mworion/Mechanics/README.md

# Mechanics
Mechanical Ideas for Astro Imaging
