mworion/Mechanics/source/mechanics/cables_qhy/index.rst

Securing power and USB connector
================================

.. warning:: Before starting please check if this solution also work for your
             environment. This means please check carefully dimensions and
             devices. This setup might not work for you.

.. warning:: Changes on all devices are made at your own risk!

Description of parts for QSI690 connectors
------------------------------------------

Image of the thread on the QSI690 filter wheel

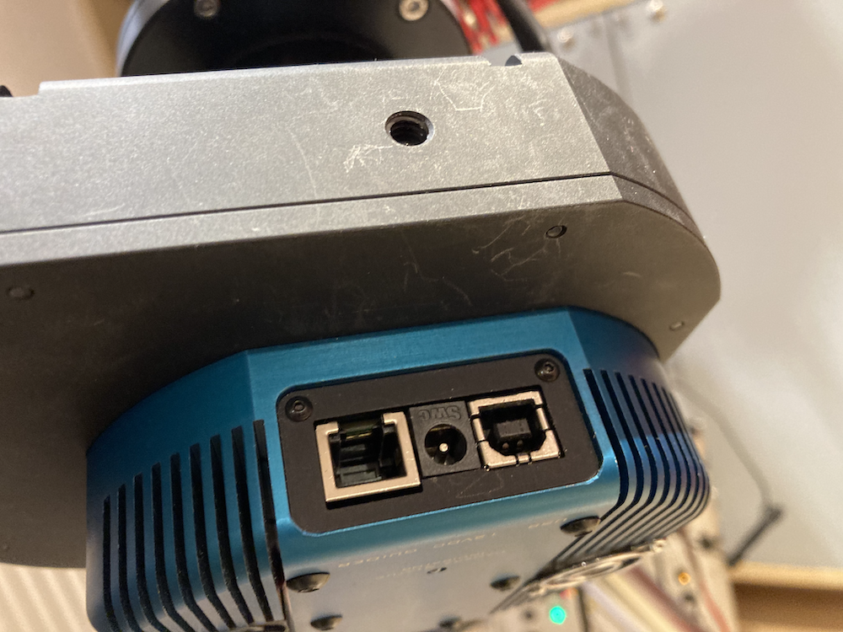
[picture p14: source/mechanics/image/img_9551.png]
