mworion/Mechanics/source/mechanics/cables_rig/index.rst

Cable Management On Rig
=======================
As I do not like cable ties to be spread overall, I started to get a clean cable
management on the rig itself. For this reason I started to print cable channels,
which are attached to the dovetails. The advantage is if you need to remove a wire
you just could do it without any tools.

So I started removing all the cable ties from my rig. PartI.

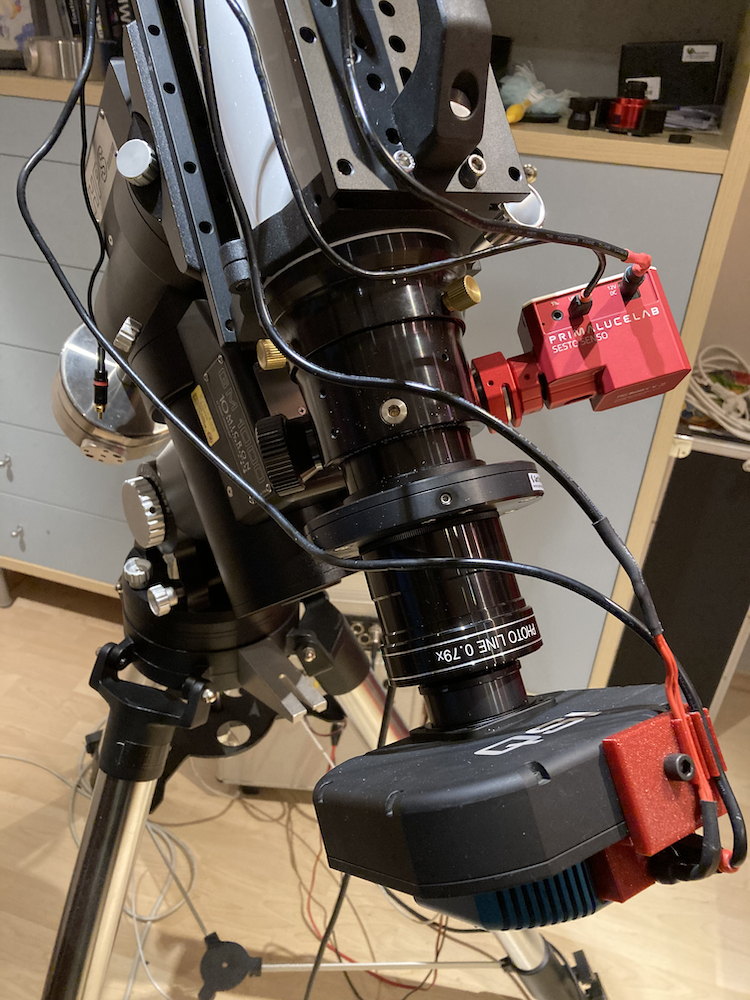
[picture p15: source/mechanics/cables_rig/image/img_9575.png]


Part II.

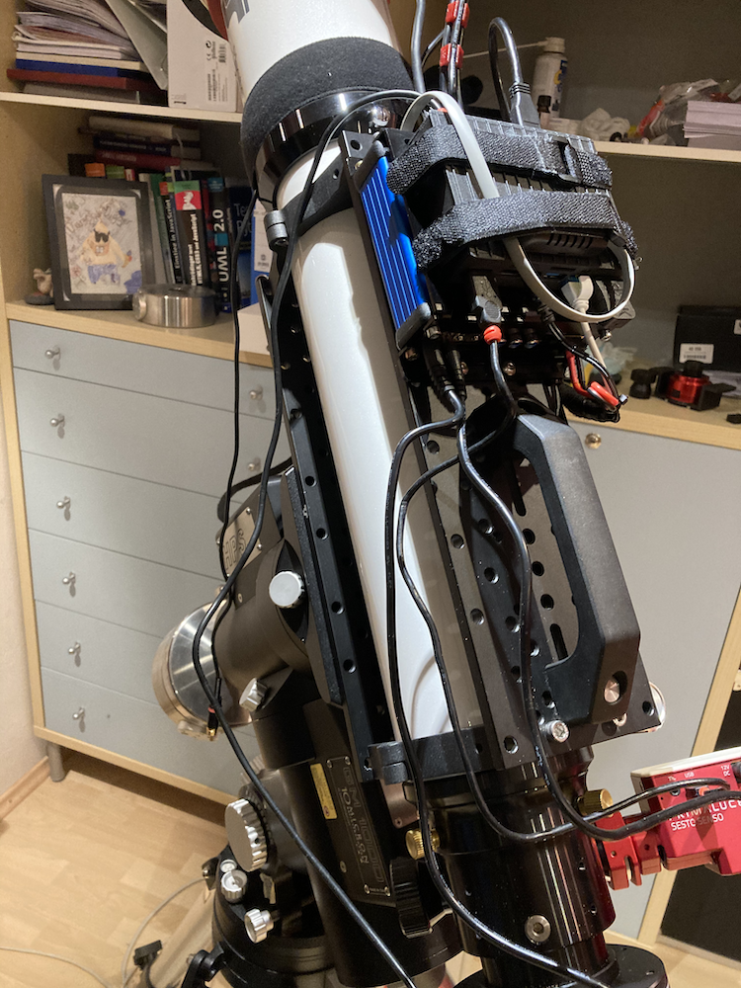
[picture p16: source/mechanics/cables_rig/image/img_9576.png]


And the printed channels attached to the dovetail.

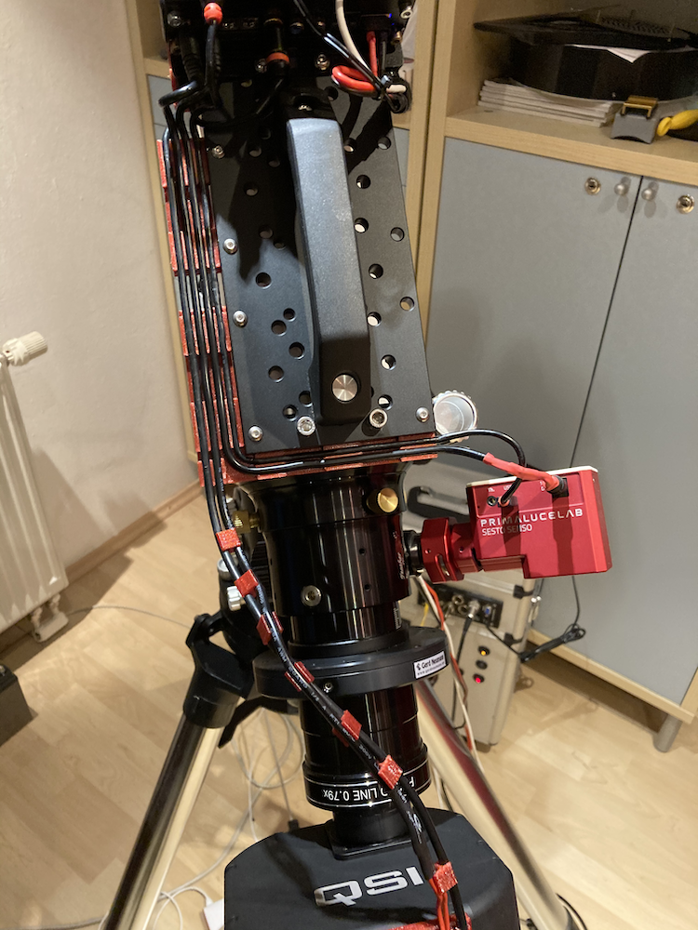
[picture p17: source/mechanics/cables_rig/image/img_9577.png]


I also did some clips to attach two cable to each other.

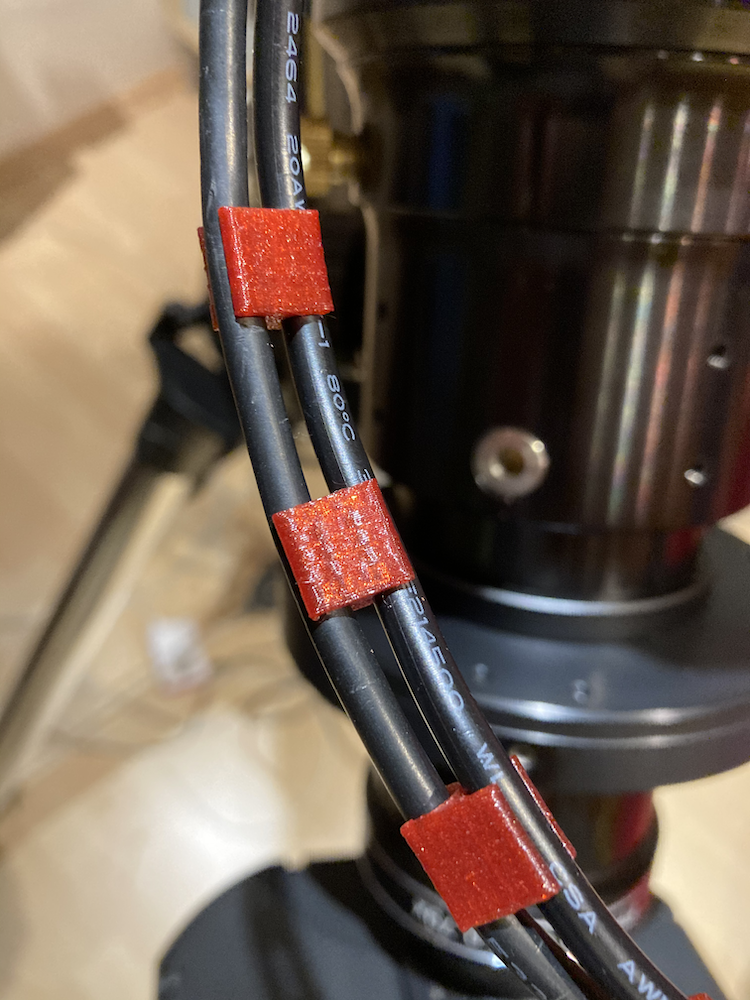
[picture p18: source/mechanics/cables_rig/image/img_9578.png]


Detailed view on the left side where the connections for focuser and ccd (USB and
power) are alinged to each other.

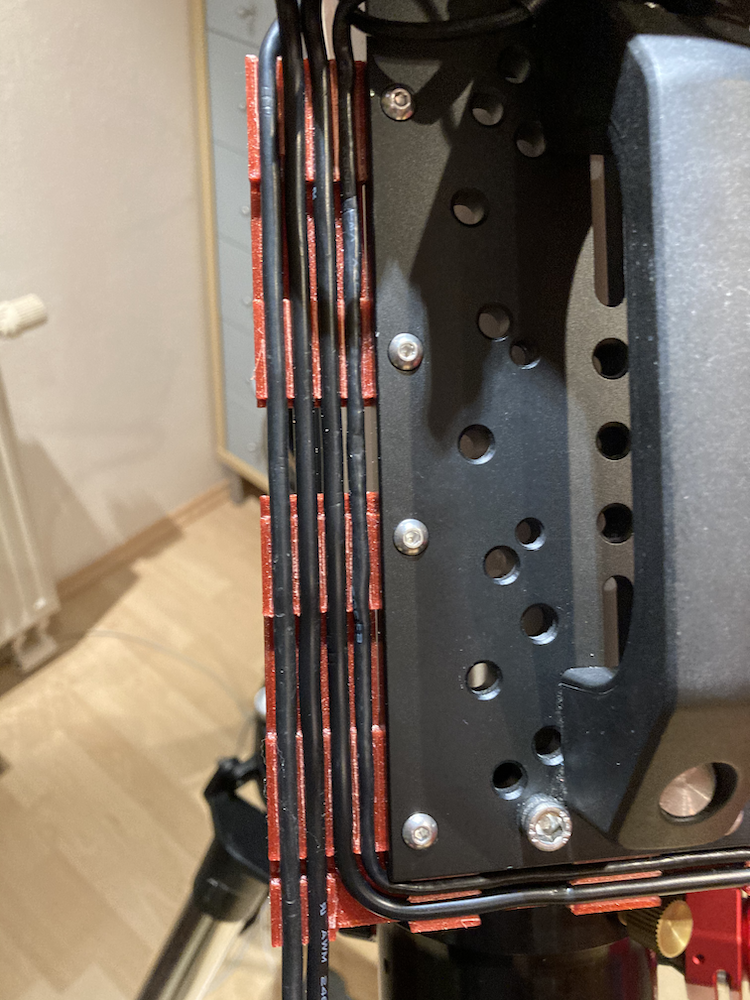
[picture p19: source/mechanics/cables_rig/image/img_9579.png]


The two lines which direct to the focuser on the right side.

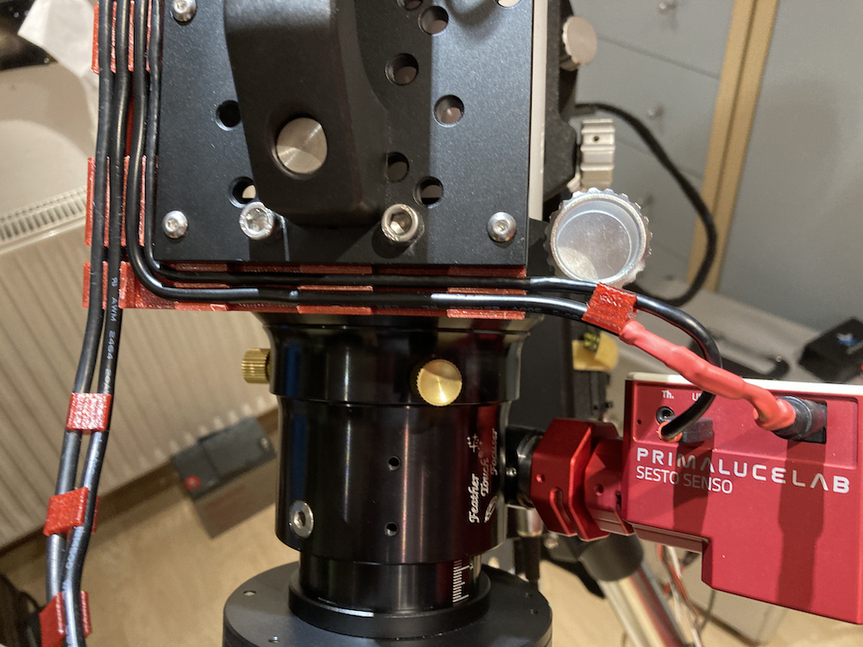
[picture p20: source/mechanics/cables_rig/image/img_9580.png]


Passing the Pegasus UPB below with Power for Dew and the USB for the camera (which
is attache to the front of the Mini PC (USB3). Part I

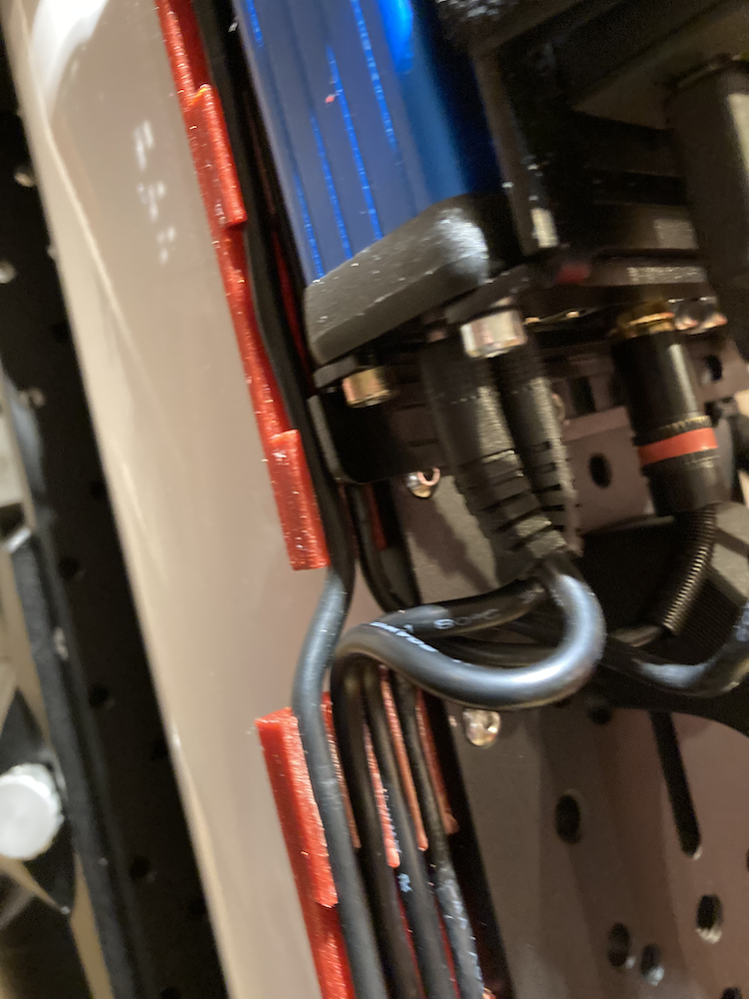
[picture p21: source/mechanics/cables_rig/image/img_9581.png]


Part II

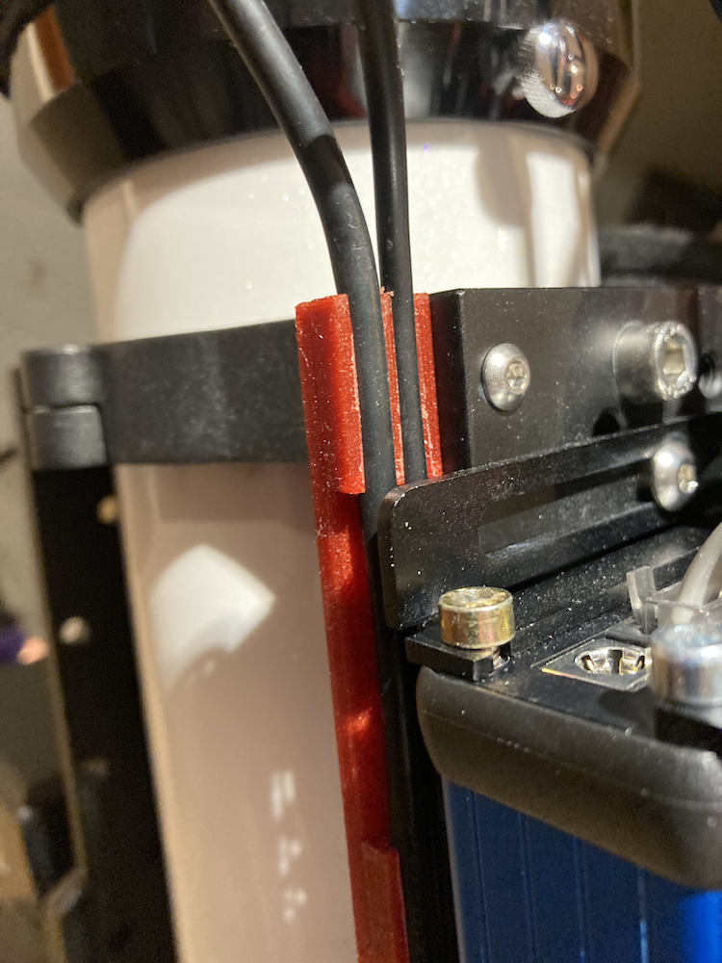
[picture p22: source/mechanics/cables_rig/image/img_9582.png]
