mworion/Mechanics/source/mechanics/cables_qsi/index.rst

Securing power and USB connector
================================

.. warning:: Before starting please check if this solution also work for your
             environment. This means please check carefully dimensions and
             devices. This setup might not work for you.

.. warning:: Changes on all devices are made at your own risk!

Description of parts for QSI690 connectors
------------------------------------------

.. note:: Please use adequate parts if you would like to follow the example. In
          my setup the wires are used for connecting to PegasusUPBv2.

Two part for the holder and one screw fitting to the thread in the attached
filter wheel of the QSI camera

The wo holder parts

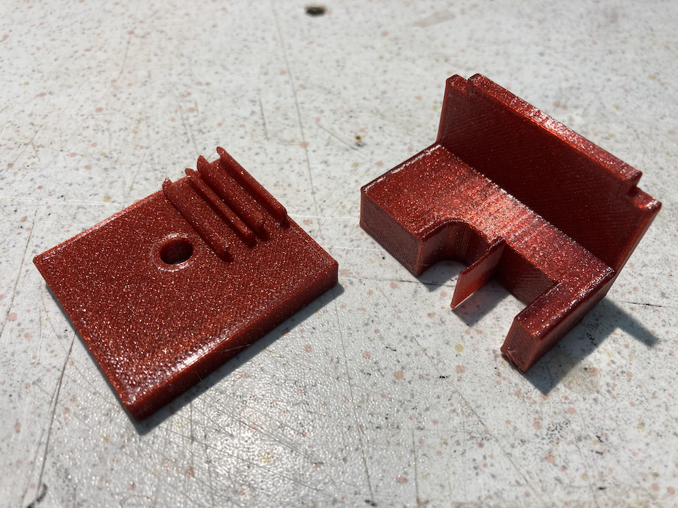
[picture p23: source/mechanics/cables_qsi/image/img_9549.png]


The fit together without any tool needed.

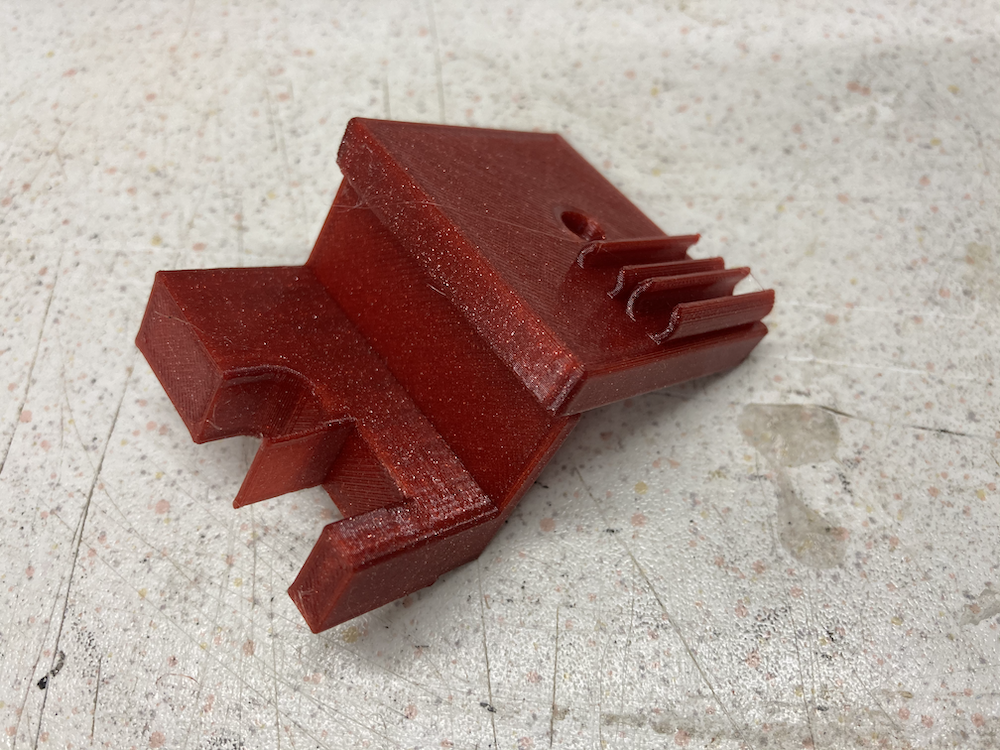
[picture p24: source/mechanics/cables_qsi/image/img_9550.png]


Image of the thread on the QSI690 filter wheel



1. Step: attaching the combined holder to the filter wheel
----------------------------------------------------------
Put the holder in top of the filter wheel and fit the screw

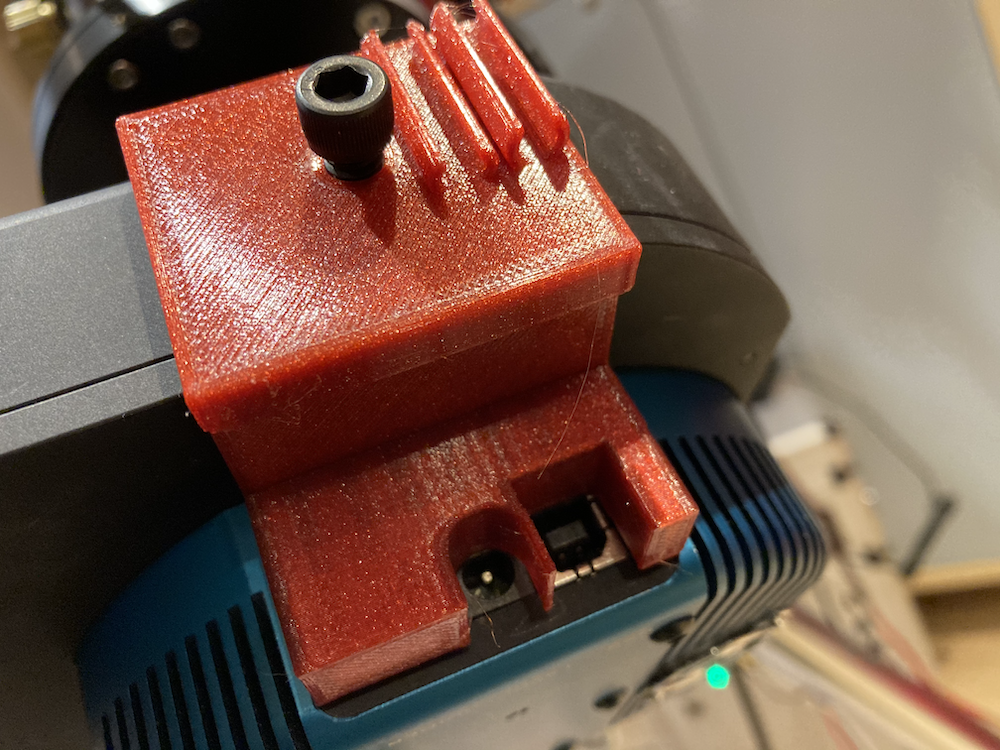
[picture p25: source/mechanics/cables_qsi/image/img_9552.png]


2. Step: tighten the screw and attaching the USB and power connector
--------------------------------------------------------------------

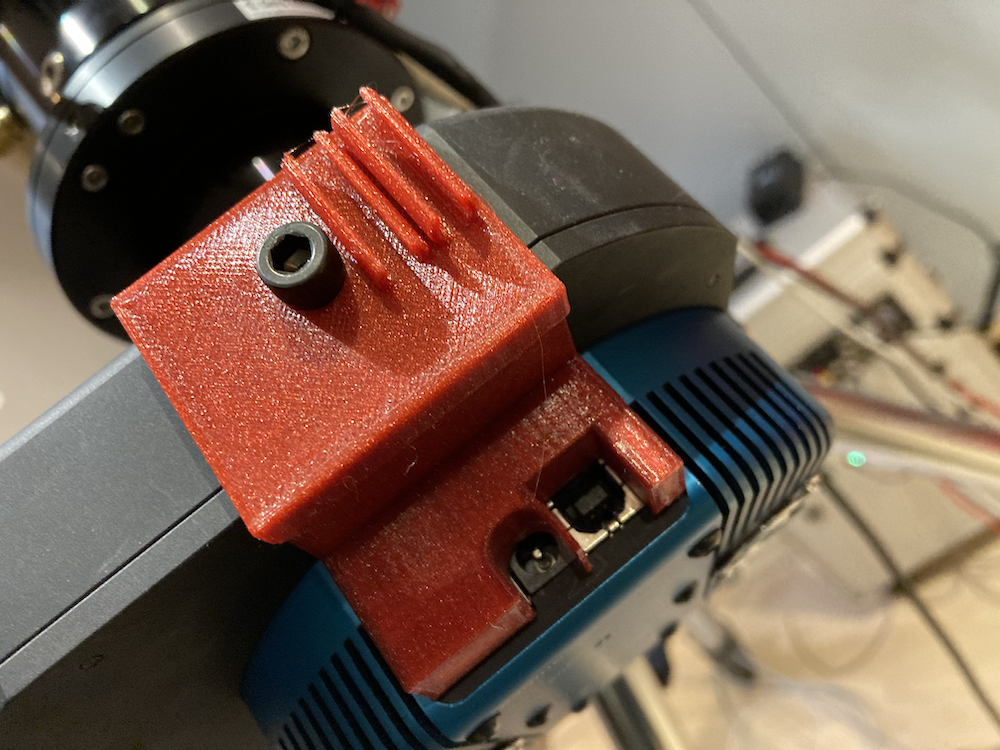
[picture p26: source/mechanics/cables_qsi/image/img_9553.png]


USB and power connector should fit in the designed places tight, but without
great force and keep them in the connector.

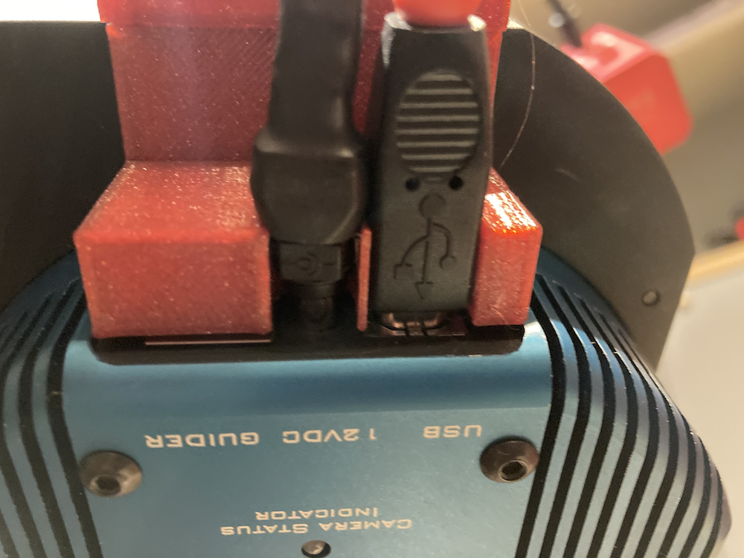
[picture p27: source/mechanics/cables_qsi/image/img_9554.png]


3. Step: link the wires to the brackets in top of the holder
------------------------------------------------------------

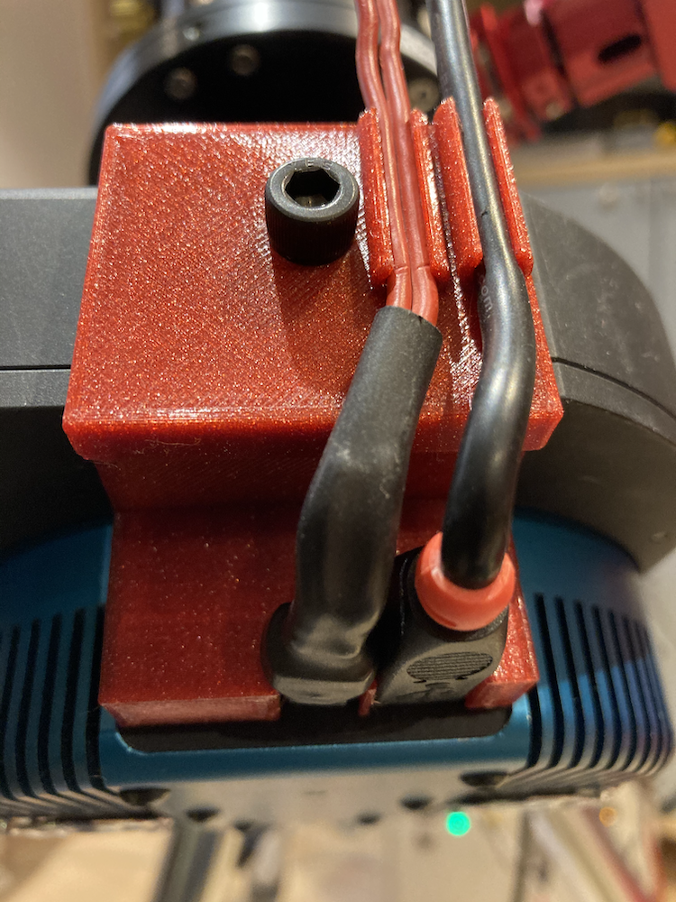
[picture p28: source/mechanics/cables_qsi/image/img_9555.png]
