mworion/Mechanics/source/mechanics/flipflat/index.rst

Mounting FlipFlat and SQR
=========================

.. warning:: Before starting please check if this solution also work for your
             environment. This means please check carefully dimensions and
             devices. This setup might not work for you.

.. warning:: Changes on all devices are made at your own risk!

Description of parts for FlipFlat / SQR holder
----------------------------------------------

.. note:: Please use adequate parts if you would like to follow the example. In
          my setup the diameter of the dew shield is 121.3 mm. It's a
          Teleskop-Express Photo Line TLAPO1027-FT.

2 x M4 x 30 mm for connection dew shield ring to holder attachment
2 x M4 x 15 mm for connecting the two dew shield rings
2 x UNC #6 x 1/2 for connecting the Alnitak FlipFlat to the holder
4 x M3 x 25mm self cutting screws for attaching the unihedron to the holder
1 base ring
1 attachment ring
1 holder

Parts: Unihedron and FlipFlat
-----------------------------
Back of the unihedron sqr with the USB interface.

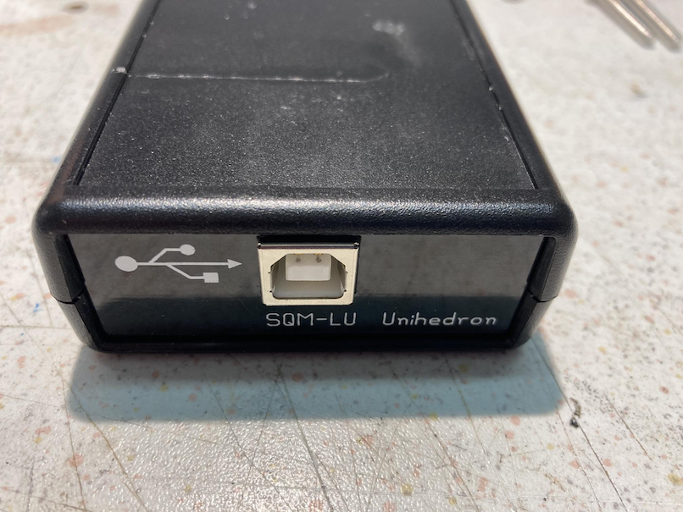
[picture p29: source/mechanics/flipflat/image/img_9482.png]


Front of the unihedron sqr with lens.

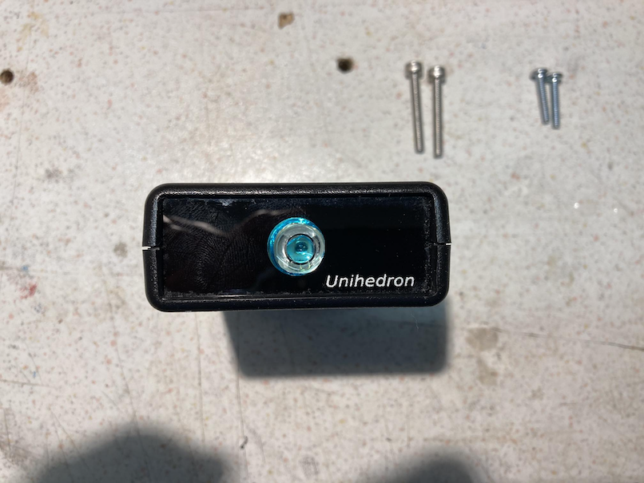
[picture p30: source/mechanics/flipflat/image/img_9483.png]


Alnitak Flip Flat device without any original holder part attached.

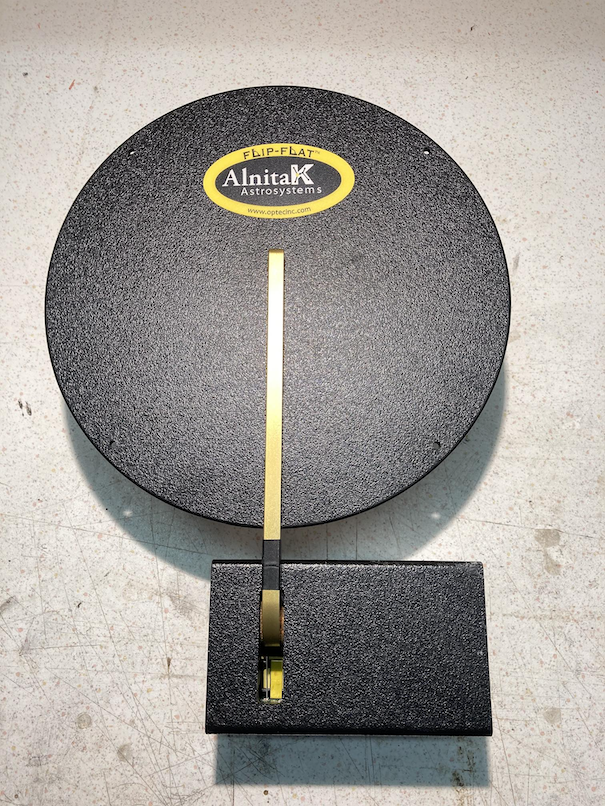
[picture p31: source/mechanics/flipflat/image/img_9484.png]


The holder which fixes FlipFlat and unihedron and makes the link to the dew
shield ring.

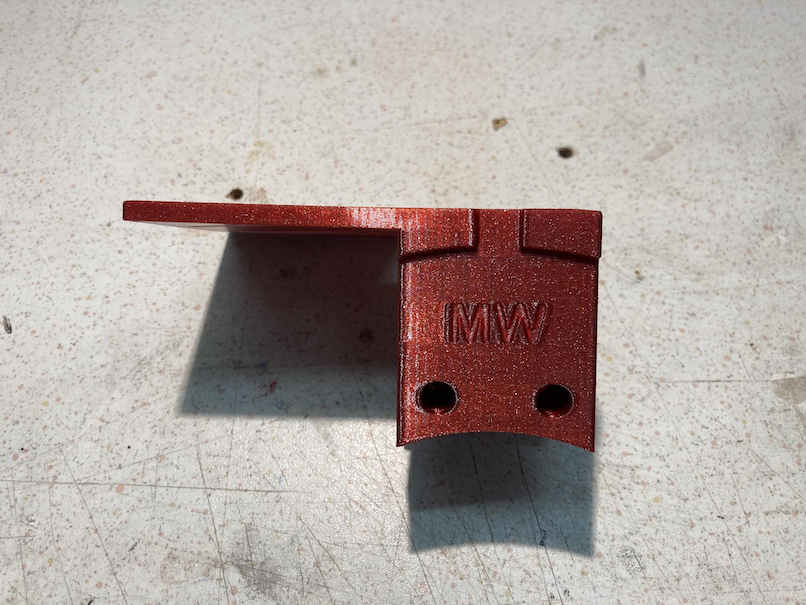
[picture p32: source/mechanics/flipflat/image/img_9485.png]


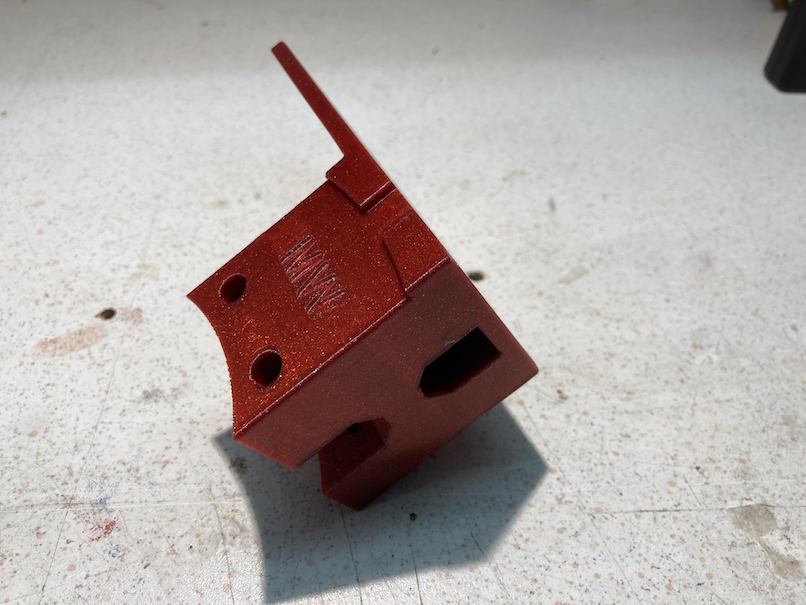
[picture p33: source/mechanics/flipflat/image/img_9486.png]


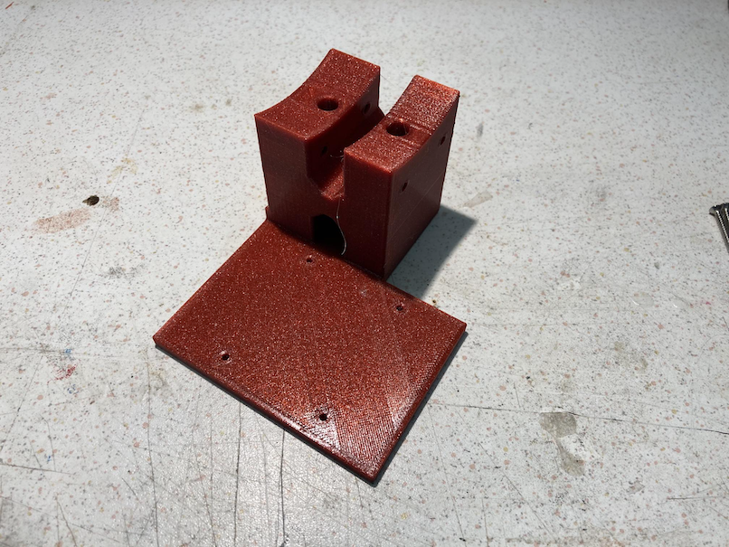
[picture p34: source/mechanics/flipflat/image/img_9487.png]


1. Step: attaching the unihedron to the holder
----------------------------------------------
Please remove to original 4 screws, which close the package of the device from
the button. Put the device upside down below the holder part and use the 4 self
cutting screws to fix the unihedron to the holder.

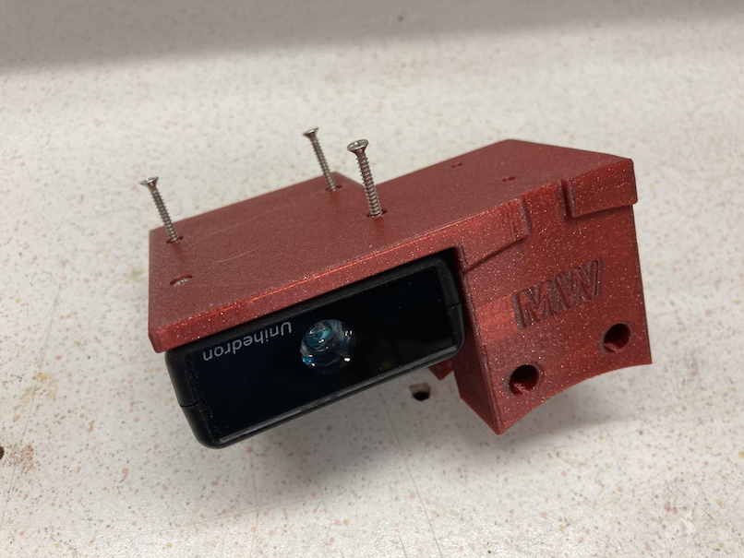
[picture p35: source/mechanics/flipflat/image/img_9488.png]


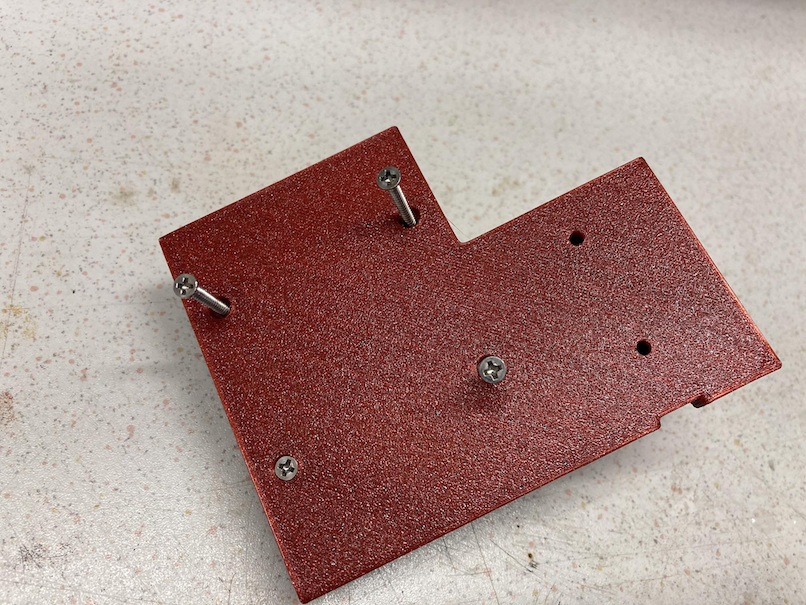
[picture p36: source/mechanics/flipflat/image/img_9489.png]


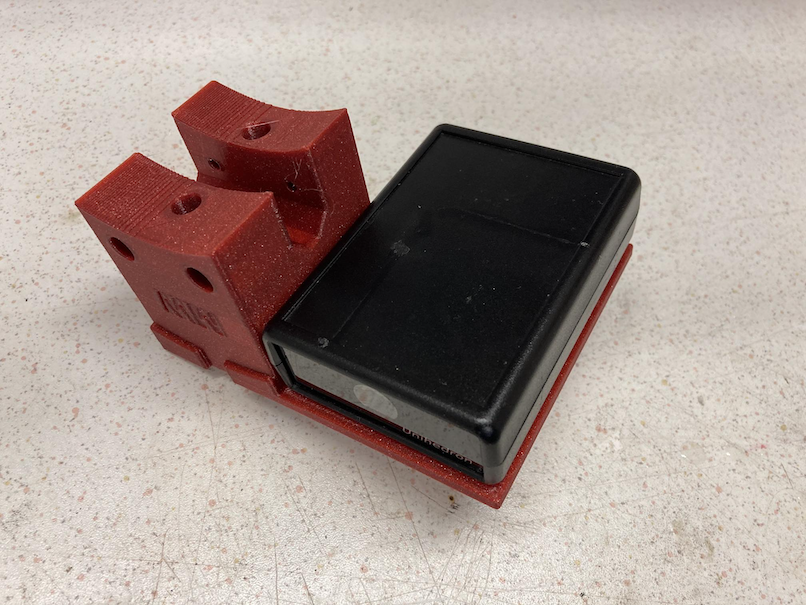
[picture p37: source/mechanics/flipflat/image/img_9490.png]


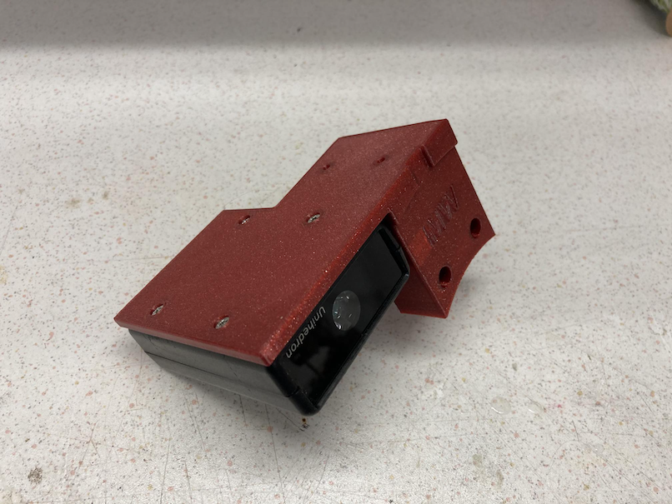
[picture p38: source/mechanics/flipflat/image/img_9491.png]


The screws should fit easily and should not stand out of the surface.

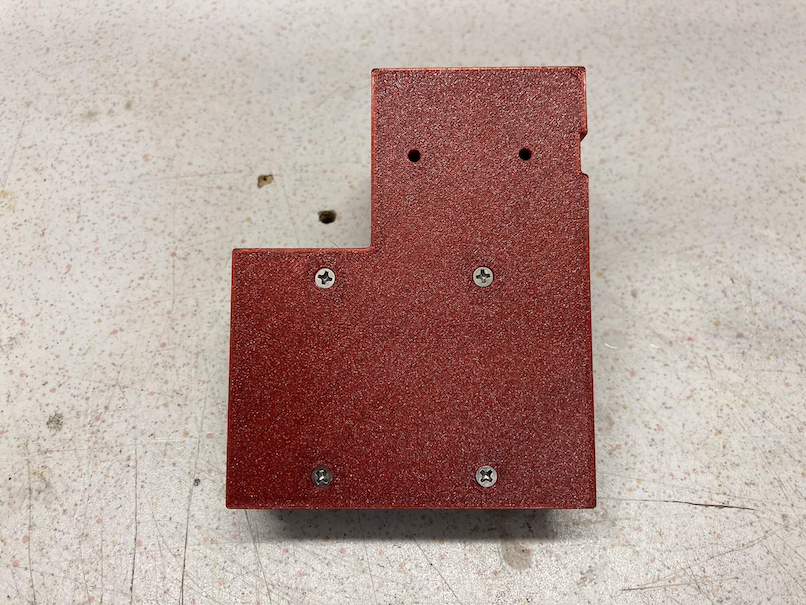
[picture p39: source/mechanics/flipflat/image/img_9492.png]


2. Step: screw on the FlipFlat to the holder
--------------------------------------------
Plug in the screws for the FlipFlat

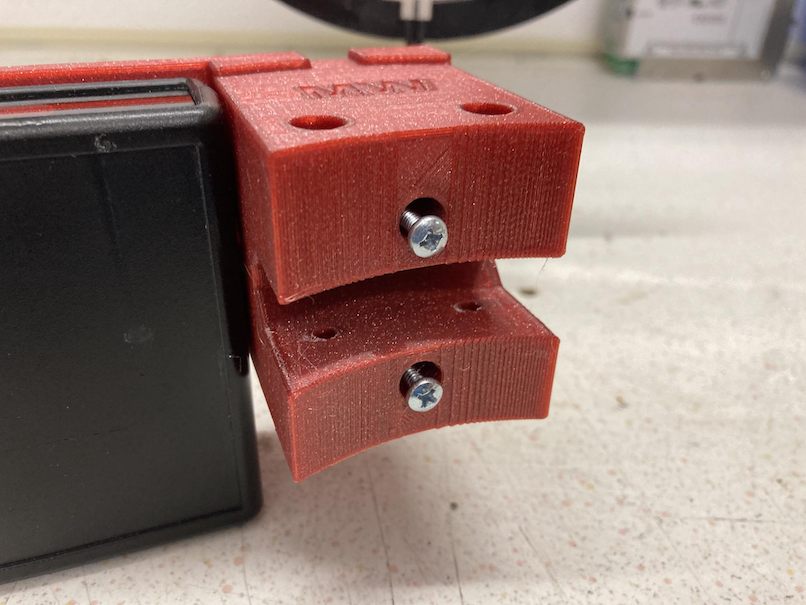
[picture p40: source/mechanics/flipflat/image/img_9493.png]


and turn them until they are equal to the surface of the holder.

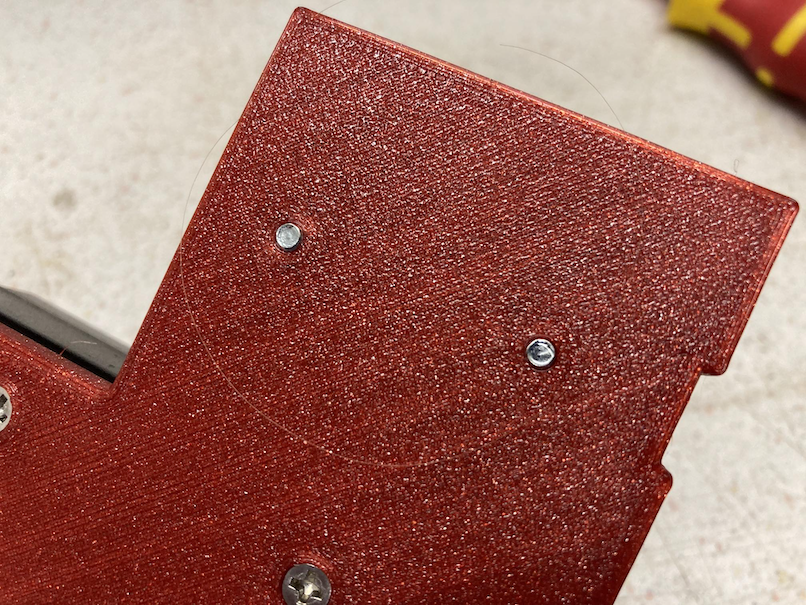
[picture p41: source/mechanics/flipflat/image/img_9494.png]


Both screws should fit into the thread nut of the FlipFlat

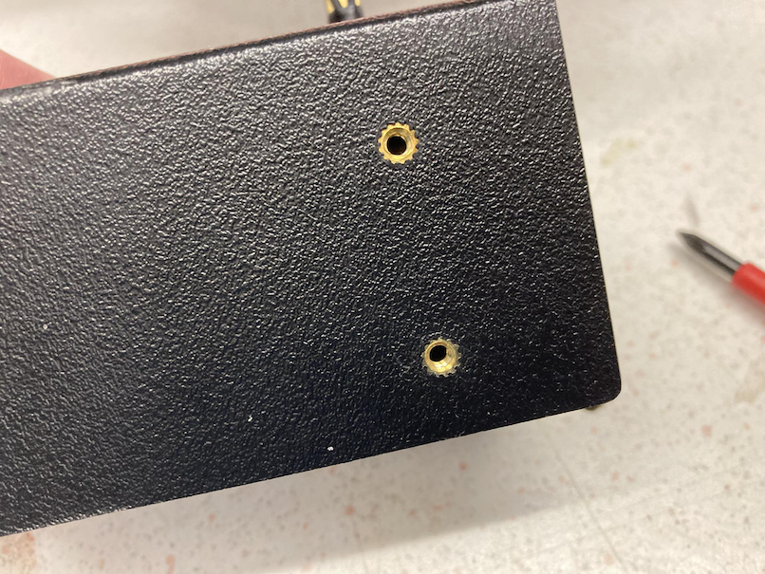
[picture p42: source/mechanics/flipflat/image/img_9495.png]


Hand tighten the screws.

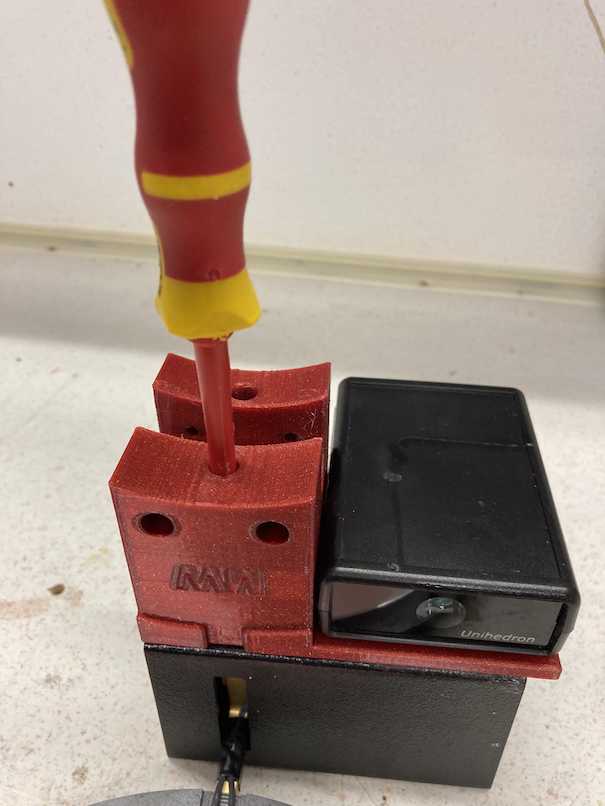
[picture p43: source/mechanics/flipflat/image/img_9496.png]


Now you got the holder with the attached devices.

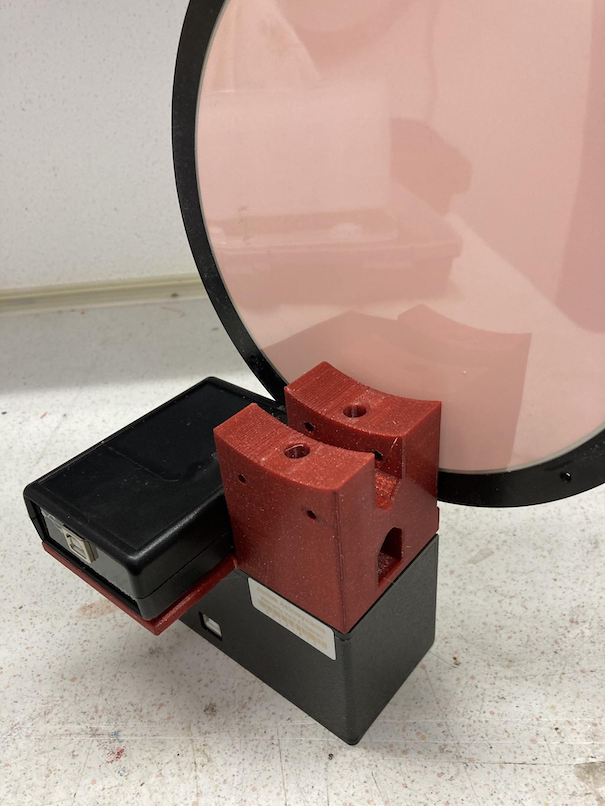
[picture p44: source/mechanics/flipflat/image/img_9497.png]


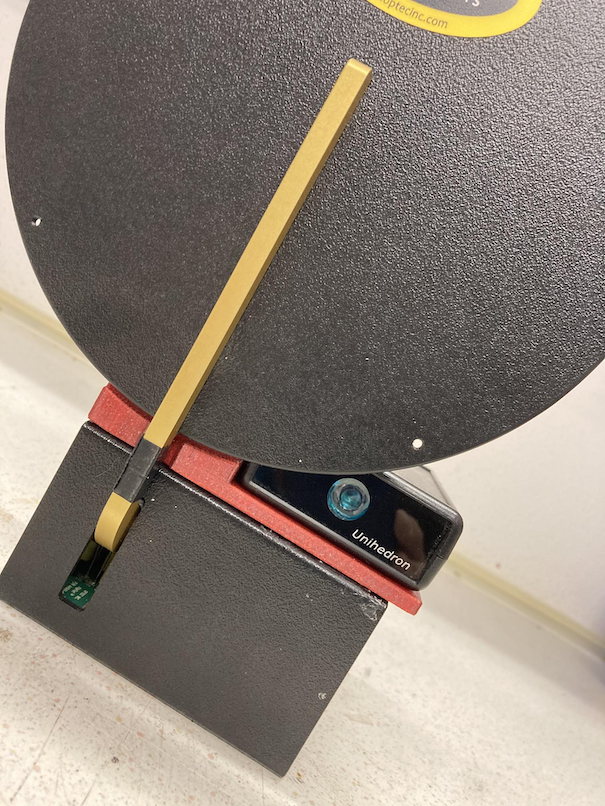
[picture p45: source/mechanics/flipflat/image/img_9498.png]


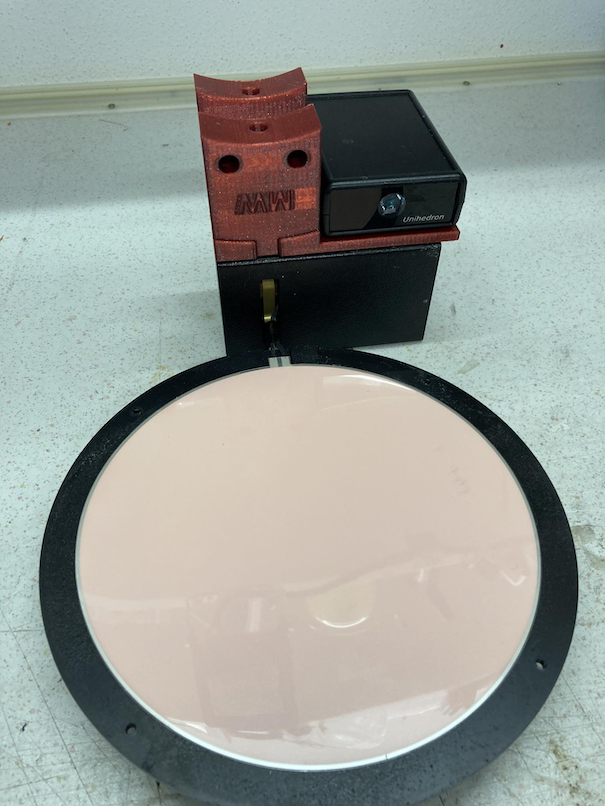
[picture p46: source/mechanics/flipflat/image/img_9499.png]


3. Step: attach the two drew shield rings
-----------------------------------------
The OTA ring with the nose should be on the upper side of the OTA the second on
the lower side. Use two M4 screws to tighten the connection. As I used PETG, I
did not need a thread nut. please check this in your case.
The OTA ring should be directly linked to the drew shield end.

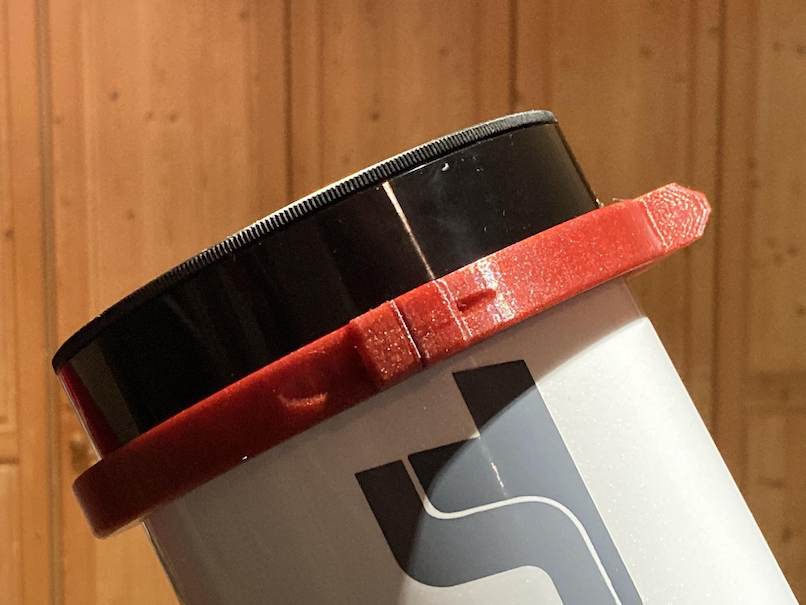
[picture p47: source/mechanics/flipflat/image/img_9501.png]


4. Step: attach the holder to the dew shield ring nose
------------------------------------------------------
The holder slips exactly on the nose of the dew shield rings.

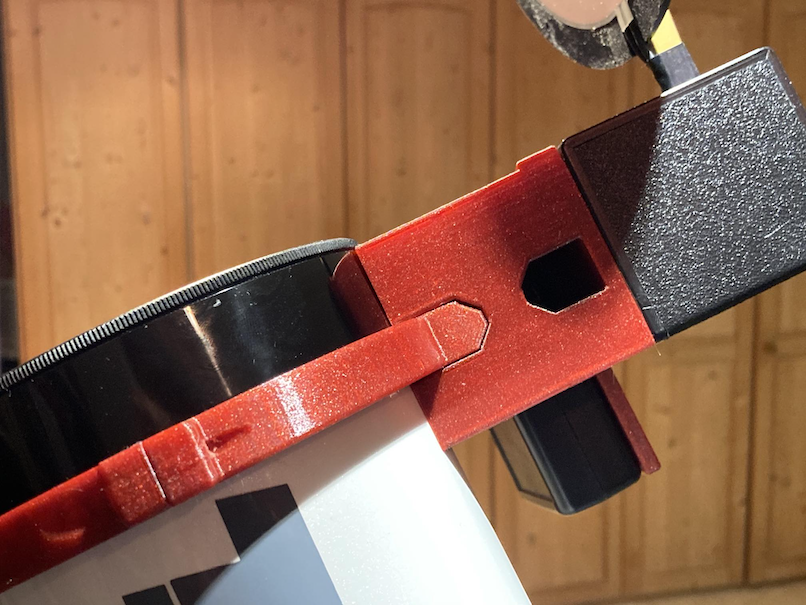
[picture p48: source/mechanics/flipflat/image/img_9502.png]


It will be fixed by 2 M4 screws. These screws are inserted from the front.

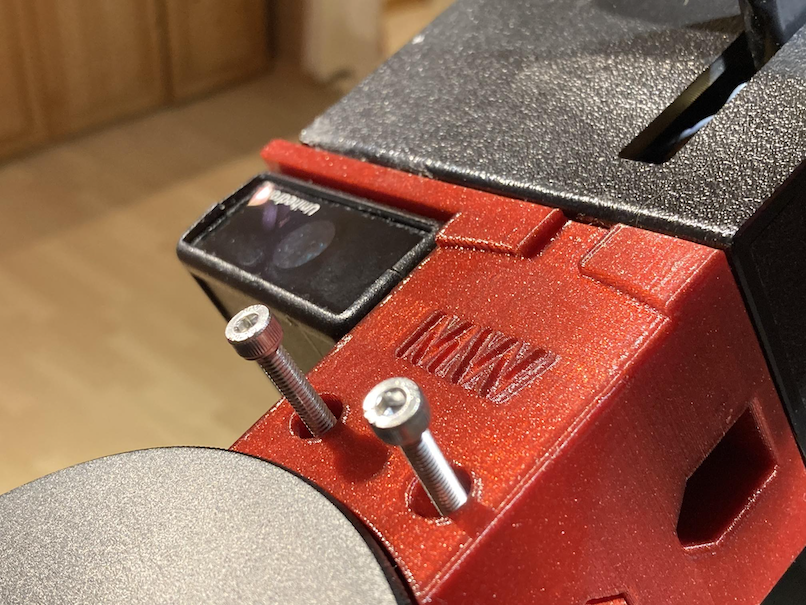
[picture p49: source/mechanics/flipflat/image/img_9503.png]


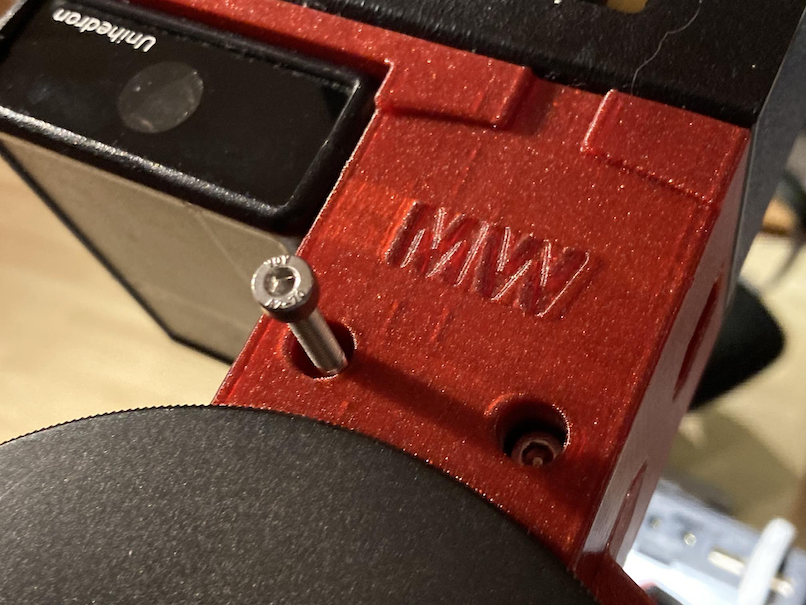
[picture p50: source/mechanics/flipflat/image/img_9504.png]


To tighten it, please use an allen key.

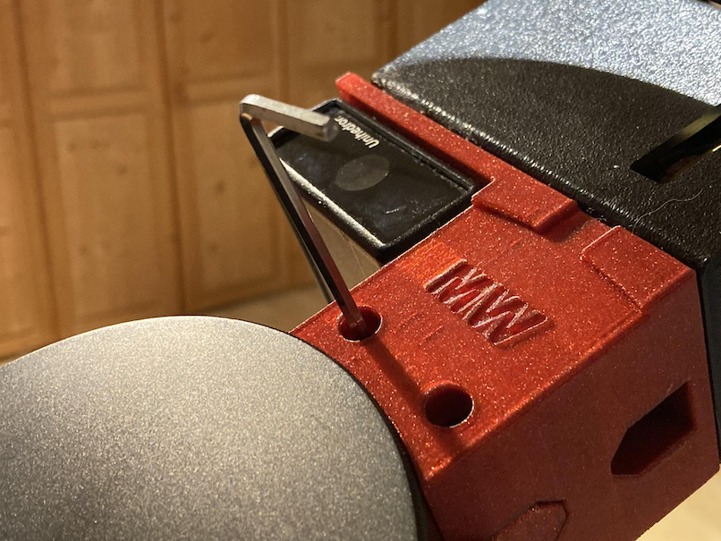
[picture p51: source/mechanics/flipflat/image/img_9505.png]


Finally you made it.

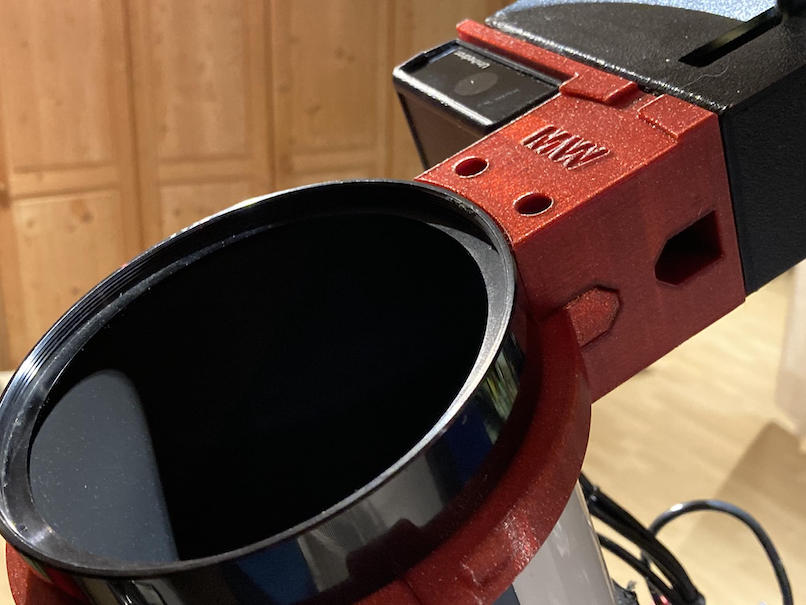
[picture p52: source/mechanics/flipflat/image/img_9506.png]


Assembled setup:
----------------
Finally you get an clean setup which both devices connected.

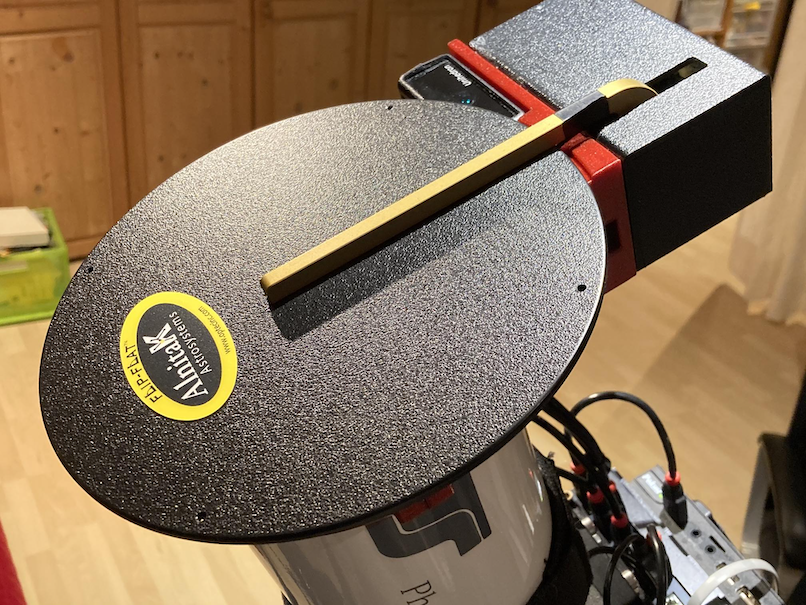
[picture p53: source/mechanics/flipflat/image/img_9507.png]


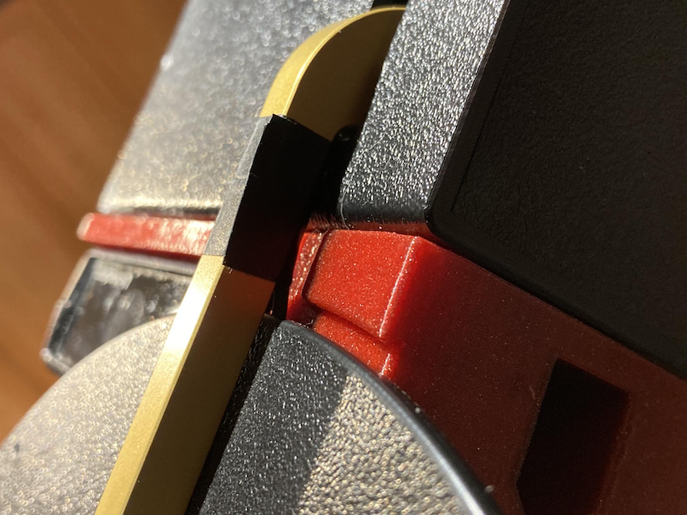
[picture p54: source/mechanics/flipflat/image/img_9508.png]


Connect the USB cables and your are set !

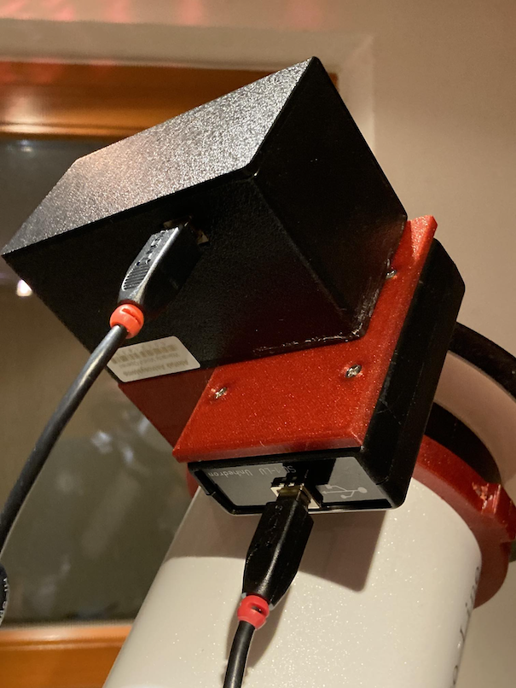
[picture p55: source/mechanics/flipflat/image/img_9509.png]


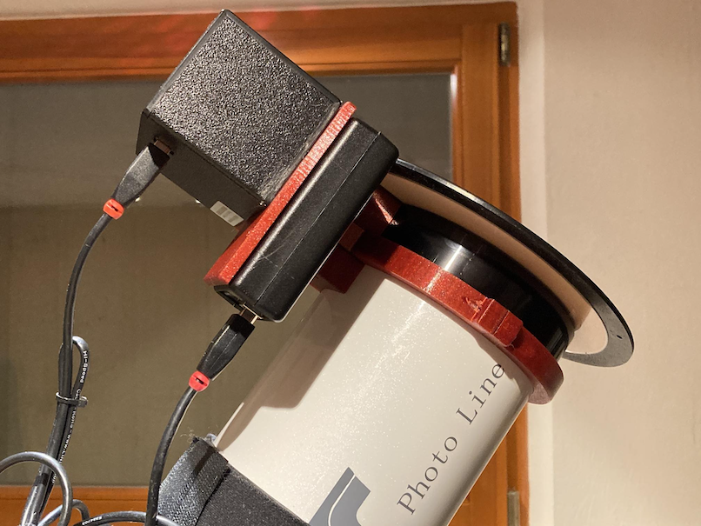
[picture p56: source/mechanics/flipflat/image/img_9510.png]
