mworion/Mechanics/source/index.rst

.. toctree::
    :maxdepth: 3

    overview
    mechanics/cables_mount_qsi/index
    mechanics/cables_rig/index
    mechanics/flipflat/index
    mechanics/backfocus_red/index
    mechanics/backfocus_flat/index
    mechanics/cables_qsi/index
    changelog

* :ref:`search`
