mworion/Mechanics/source/_static/mw4.png

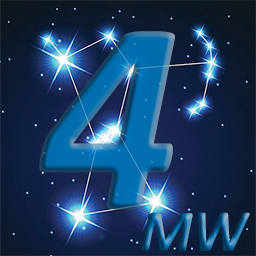
source/_static/mw4.png
