mworion/Mechanics/3D_Models/cable-holder-part1.stl

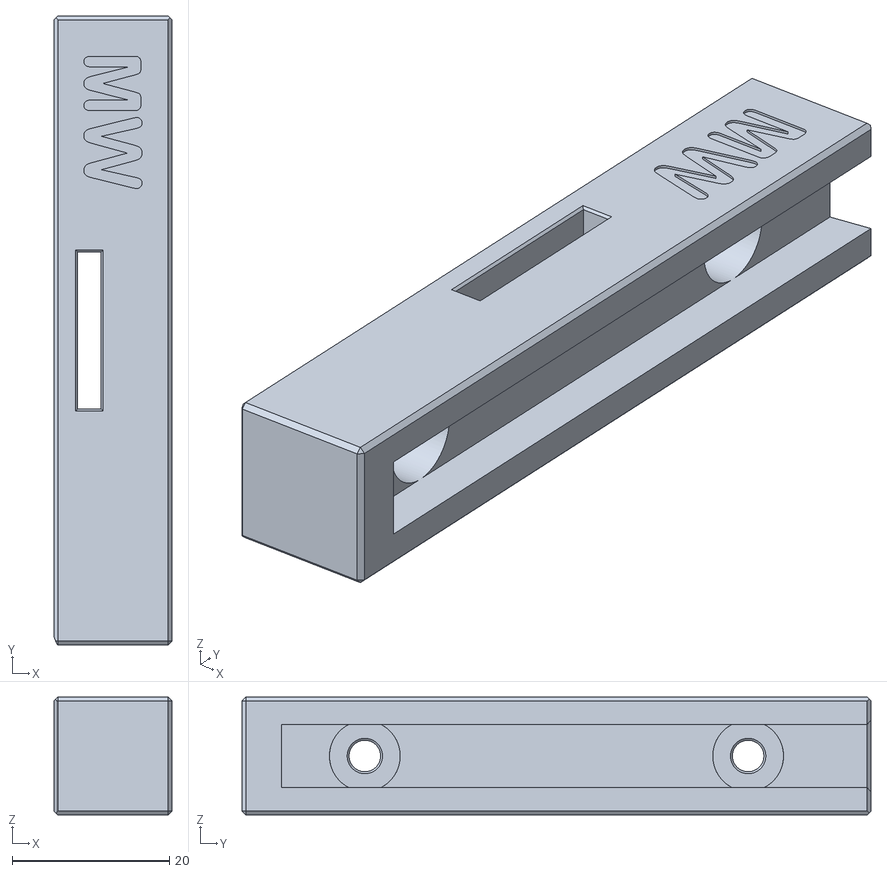
[picture p59: CAD file, 2021-01-31]
3D_Models/cable-holder-part1.stl
15.0 x 80.0 x 15.0
