mworion/Mechanics/3D_Models/cable-plate.stl

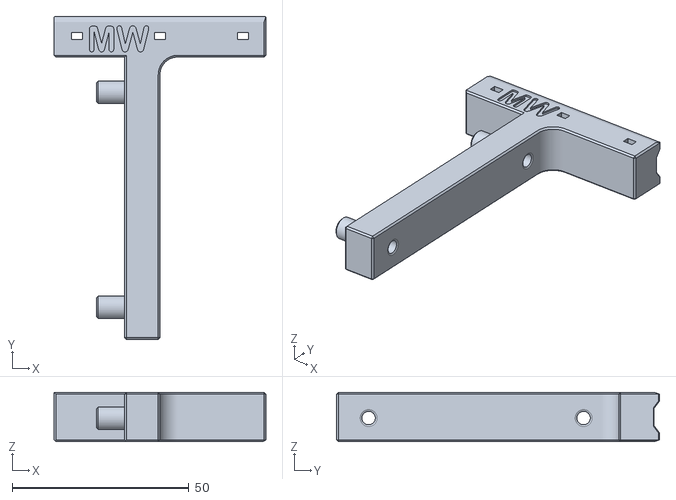
[picture p60: CAD file, 2021-01-31]
3D_Models/cable-plate.stl
60.0 x 91.5 x 14.0
