mworion/Mechanics/3D_Models/traeger-flipflat-2.stl

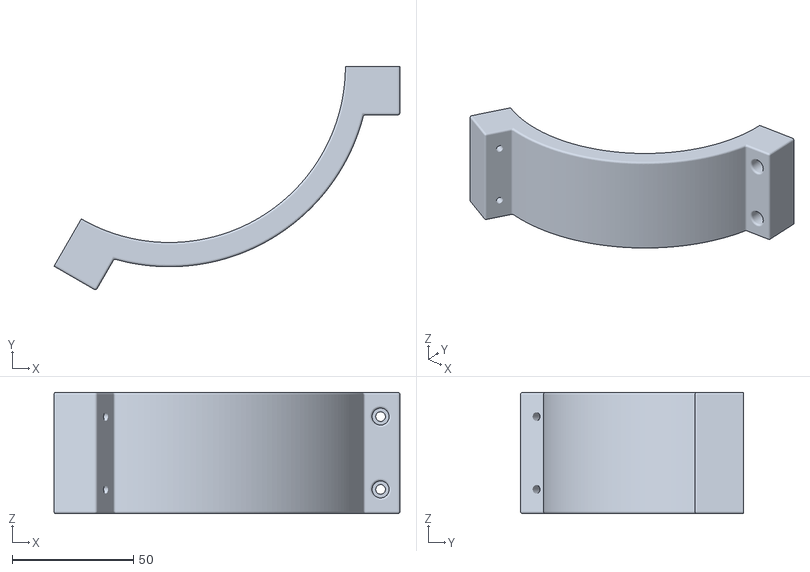
[picture p61: CAD file, 2021-01-31]
3D_Models/traeger-flipflat-2.stl
142.5 x 91.9 x 50.0
