mworion/Mechanics/3D_Models/cable-holder-part4.stl

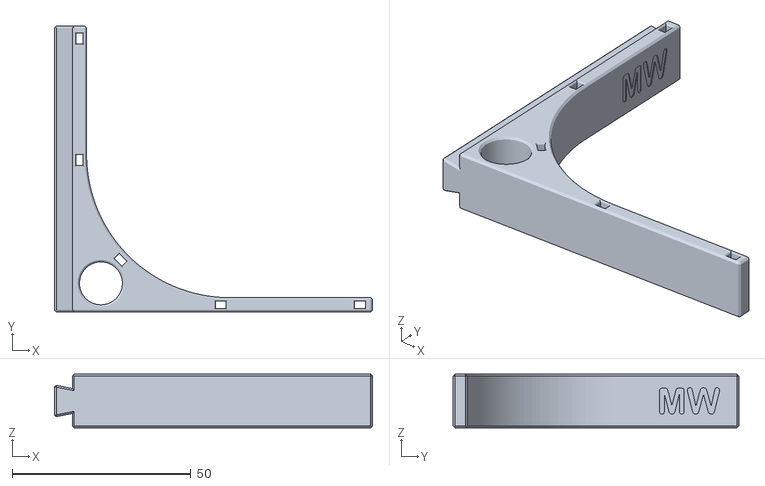
[picture p62: CAD file, 2021-01-31]
3D_Models/cable-holder-part4.stl
89.0 x 80.0 x 15.0
