mworion/Mechanics/3D_Models/cable-counterweight-part1.stl

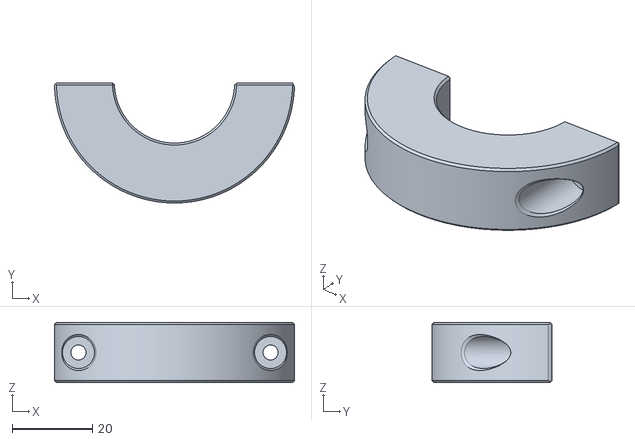
[picture p63: CAD file, 2021-01-31]
3D_Models/cable-counterweight-part1.stl
60.0 x 30.0 x 15.0
