mworion/Mechanics/3D_Models/cable-holder-part3.stl

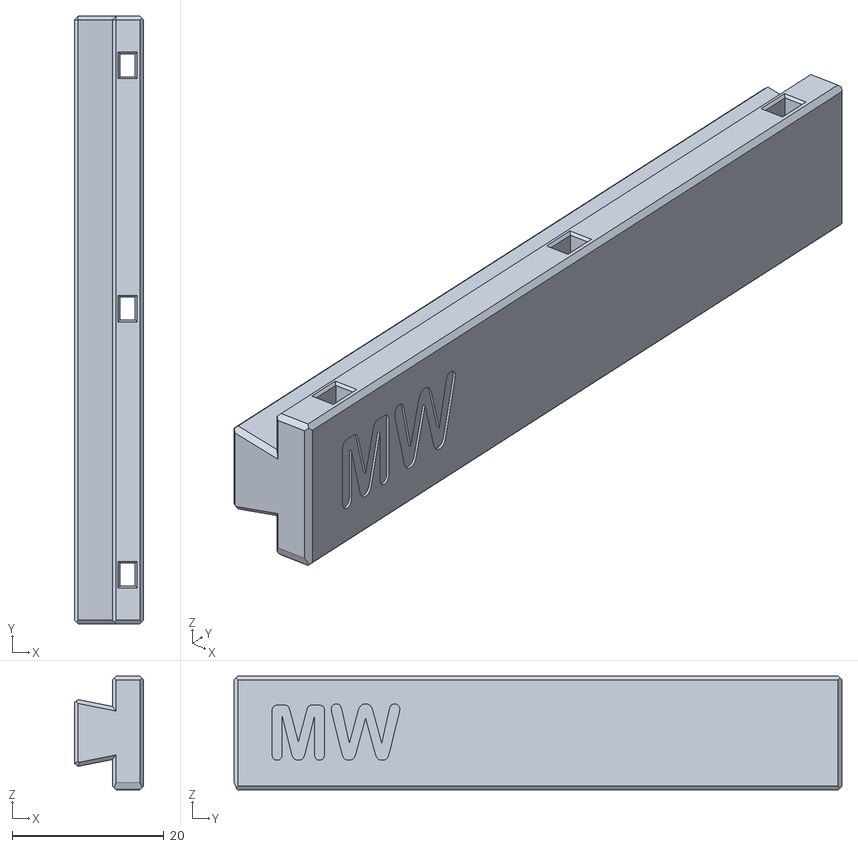
[picture p64: CAD file, 2021-01-31]
3D_Models/cable-holder-part3.stl
9.13 x 80.0 x 15.0
