mworion/Mechanics/3D_Models/cable-counterweight-part2.stl

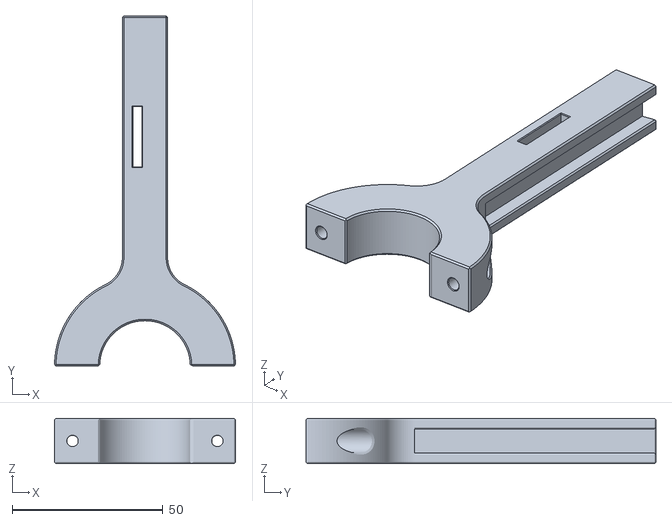
[picture p65: CAD file, 2021-01-31]
3D_Models/cable-counterweight-part2.stl
60.0 x 116.0 x 15.0
