mworion/Mechanics/3D_Models/traeger-flipflat-1.stl

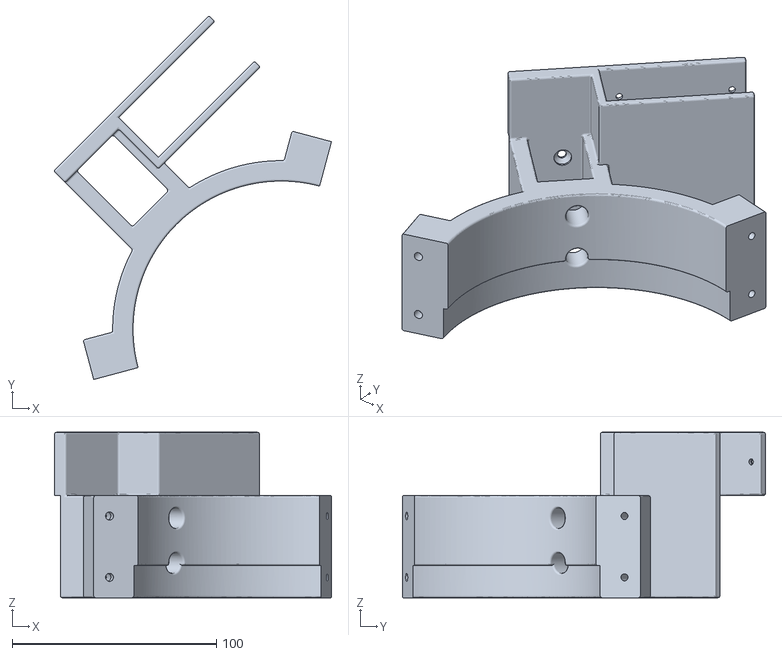
[picture p66: CAD file, 2021-01-31]
3D_Models/traeger-flipflat-1.stl
135.5 x 177.6 x 81.0
