mworion/Mechanics/source/changelog.rst

Changelog
=========
The changelog contains the user related function or environment updates. For a
detailed changes list, please refer to the commit list on GitHub.

1.0
---

- Initial release as a separate repository with all the data.
