mworion/Mechanics/(commit log)

2021-01-31 initial release
    [cable-counterweight-part1.stl, cable-counterweight-part2.stl, cable-holder-part1.stl, cable-holder-part2.stl, cable-holder-part3.stl, cable-holder-part4.stl, cable-plate.stl, traeger-flipflat-1.stl]
2021-02-28 adding cable channels and new pictures.
